arthurmint/WearablePWV/README.md

# WearablePWV
A wearable, wireless sensor for measuring pulse-wave velocity in humans
