arthurmint/WearablePWV/Electronics/Optical Board/Optical Board.step

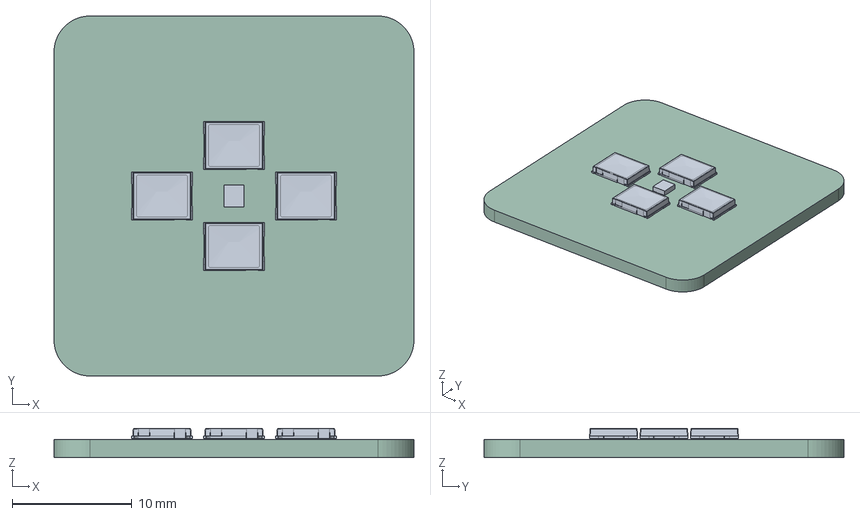
[picture p1: CAD file, 2025-12-23]
Electronics/Optical Board/Optical Board.step
30.0 x 30.0 x 2.45 mm
SFH_7016_20230526_geometry
SFH_2200_20170928_geometry x 4
Optical Board_PCB
