arthurmint/WearablePWV/Electronics/V1/V1.step

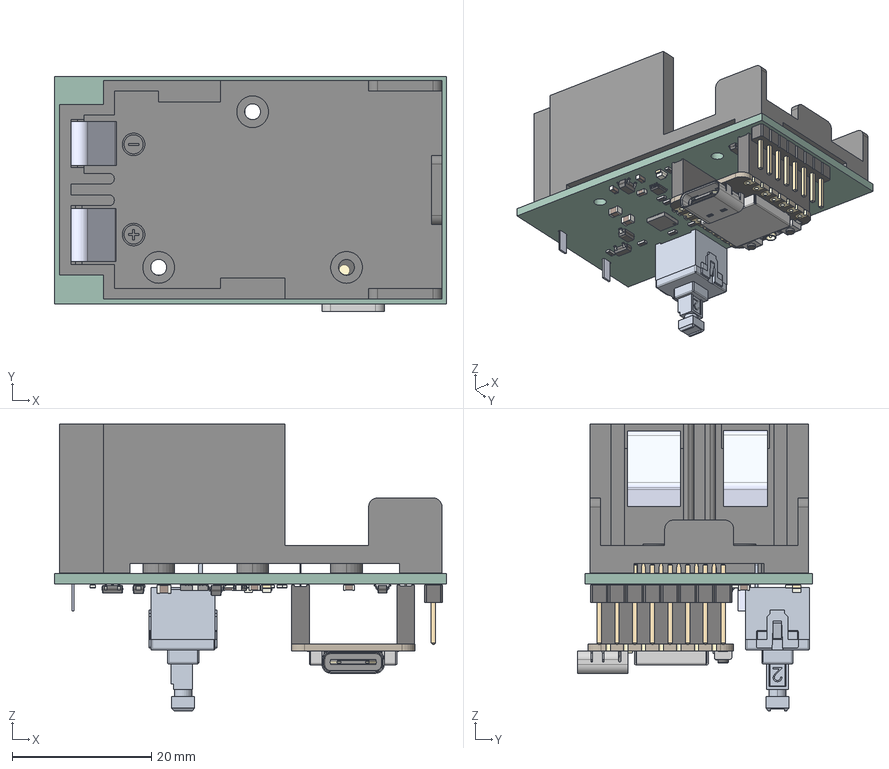
[picture p2: CAD file, 2025-12-23]
Electronics/V1/V1.step
56.3 x 33.8 x 41.2 mm
BA9VPC
C_0603_1608Metric x 10
R_0603_1608Metric x 14
LED_0805_2012Metric x 2
PinHeader_1x08_P2.54mm_Vertical
C_0805_2012Metric x 2
BOSS-EXTRUDE14_8_
BOSS-EXTRUDE7_4_
BOSS-EXTRUDE7_3_
BOSS-EXTRUDE14_4_
BOSS-EXTRUDE14_2_
BOSS-EXTRUDE14_11_
BOSS-EXTRUDE7_7_
BOSS-EXTRUDE14_9_
BOSS-EXTRUDE14_3_
BOSS-EXTRUDE14_7_
MIRROR2
BOSS-EXTRUDE14_5_
BOSS-EXTRUDE14_12_
BOSS-EXTRUDE7_8_
BOSS-EXTRUDE7_1_
BOSS-EXTRUDE14_10_
BOSS-EXTRUDE7_9_
BOSS-EXTRUDE14_6_
BOSS-EXTRUDE14_1_
BOSS-EXTRUDE7_6_
BOSS-EXTRUDE7_2_
CUT-EXTRUDE5
BOSS-EXTRUDE7_5_
U.FL Connector v1
Button (1) x 2
Shield
PinSocket_1x07_P2.54mm_Vertical v1 x 2
SOT-23-5
V1 1.18.1
ThermalPin
PinsArrayLR
PinsArrayTB
VSSOP-8_2.3x2mm_P0.5mm x 2
D_SOD-123
SOT-23 x 2
V1_PCB
