arthurmint/WearablePWV/Electronics/Optical Board/Optical Board.kicad_pcb

## KiCad design Electronics/Optical Board/Optical Board.kicad_pcb (2025-12-23)

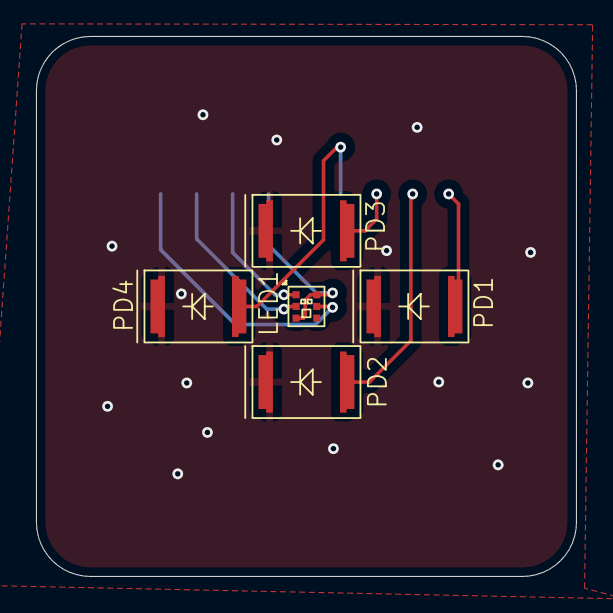
[picture p3: board Optical Board.kicad_pcb from above]

Board: 2 copper layers, 30.0 x 30.0 mm, 6 parts (1 on the bottom side), 9 nets.

Parts:
J2: OPTICAL; JST_PH_S9B-PH-SM4-TB_1x09-1MP_P2.00mm_Horizontal
LED1: SFH-7016; SFH-7016 Multi Chip LED
PD1, PD2, PD3, PD4: SFH2200; TOPLED D5140

Connections:
+3V3: J2.4, LED1.2 (A), LED1.5 (A)
/LED1: J2.3, LED1.1 (KIR)
/LED2: J2.2, LED1.3 (KGREEN)
/LED3: J2.1, LED1.4 (KRED)
/PD1: J2.9, PD1.2 (A)
/PD2: J2.8, PD2.2 (A)
/PD3: J2.7, PD3.2 (A)
/PD4: J2.6, PD4.2 (A)
/PD_K: J2.5, PD1.1 (K), PD2.1 (K), PD3.1 (K), PD4.1 (K)
