arthurmint/WearablePWV/Electronics/V1/V1.kicad_pcb

## KiCad design Electronics/V1/V1.kicad_pcb (2025-12-23)

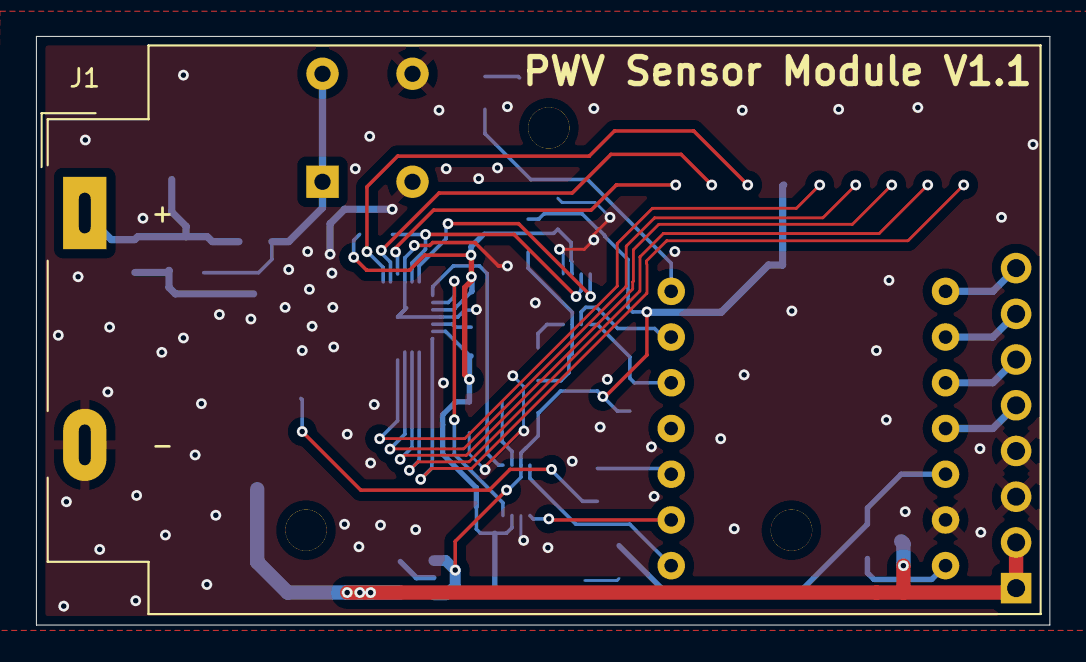
[picture p4: board V1.kicad_pcb from above]

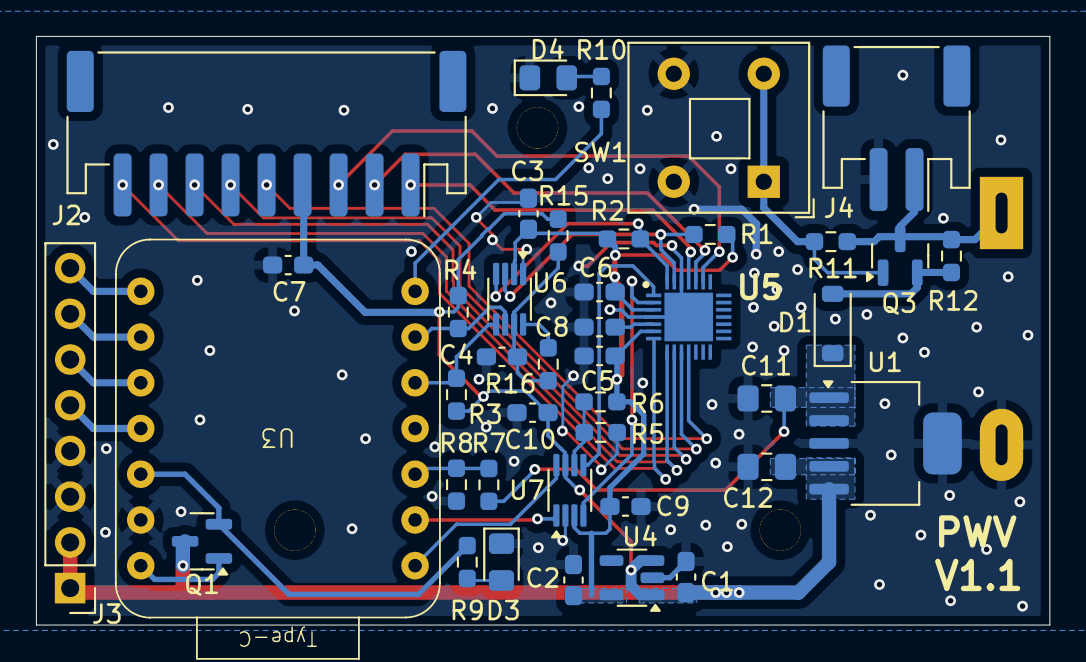
[picture p5: board V1.kicad_pcb from below]

Board: 2 copper layers, 56.3 x 32.7 mm, 42 parts (41 on the bottom side), 37 nets.

Parts:
C1, C8: 1u; C_0603_1608Metric_Pad1.08x0.95mm_HandSolder
C2: 10u; C_0603_1608Metric_Pad1.08x0.95mm_HandSolder
C3, C4, C5, C6, C9, C10: 100n; C_0603_1608Metric_Pad1.08x0.95mm_HandSolder
C7: 4u7; C_0603_1608Metric_Pad1.08x0.95mm_HandSolder
C11, C12: 10uF; C_0805_2012Metric_Pad1.18x1.45mm_HandSolder
D1: B130LAW-7-F; D_SOD-123
D3: 3V3 LED; LED_0805_2012Metric_Pad1.15x1.40mm_HandSolder
D4: CTRL LED; LED_0805_2012Metric_Pad1.15x1.40mm_HandSolder
J1: BA9VPC; BatteryHolder_MPD_BA9VPC_1xPP3
J2: OPTICAL; JST_PH_S9B-PH-SM4-TB_1x09-1MP_P2.00mm_Horizontal
J3: GPIO; PinHeader_1x08_P2.54mm_Vertical
J4: JST; JST_PH_S2B-PH-SM4-TB_1x02-1MP_P2.00mm_Horizontal
Q1, Q3: PMV41XPAR; SOT-23
R1, R2, R3, R4, R8, R11: 10k; R_0603_1608Metric_Pad0.98x0.95mm_HandSolder
R5: 200k; R_0603_1608Metric_Pad0.98x0.95mm_HandSolder
R6, R12: 0R; R_0603_1608Metric_Pad0.98x0.95mm_HandSolder
R7: 20k; R_0603_1608Metric_Pad0.98x0.95mm_HandSolder
R9, R10: 330; R_0603_1608Metric_Pad0.98x0.95mm_HandSolder
R15: 200K; R_0603_1608Metric_Pad0.98x0.95mm_HandSolder
R16: 0; R_0603_1608Metric_Pad0.98x0.95mm_HandSolder
SW1: PVA1 EE H1 3.5N V2; SW_Push_2P1T_Toggle_CK_PVA1xxH1xxxxxxV2
U1: TPS7A4533; SOT-223-6
U3: XIAO-ESP32-C3; Seeed Studio XIAO ESP32-C3
U4: TPS72218; SOT-23-5
U5: ADPD1080
U6: PCA9306DC; VSSOP-8_2.3x2mm_P0.5mm
U7: TXB0102DCU; VSSOP-8_2.3x2mm_P0.5mm

Connections:
+1V8: C2.1, C3.1, C5.1, C6.1, C9.1, R1.1, R2.1, R6.1, U4.5 (VOUT), U5.3 (DVDD), U5.6 (AVDD), U6.2 (VREF1), U7.3 (VCCA)
+3V3: C1.1, C7.1, C10.1, C12.1, J2.4, J3.1, J3.2, Q1.3 (D), R3.1, R4.1, R15.1, U1.4 (OUT), U1.5 (ADJ), U4.1 (VIN), U4.3 (EN), U7.7 (VCCB)
/AFE_0: U5.1 (GPIO0), U7.5 (A1)
/AFE_1: U5.2 (GPIO1), U7.4 (A2)
/BAT+: J1.1, J4.1, Q3.3 (D), R11.1, R12.1
/BAT_SENSE: R7.2, R8.1, U3.3 (D2)
/LED1: J2.3, U5.23 (LEDX1)
/LED2: J2.2, U5.24 (LEDX2)
/LED3: J2.1, U5.25 (LEDX3)
/PD1: J2.9, U5.7 (PD1)
/PD2: J2.8, U5.8 (PD2)
/PD3: J2.7, U5.9 (PD3)
/PD4: J2.6, U5.10 (PD4)
/PD_K: J2.5, U5.11 (PDC)
/PPG_SCL: R1.2, U5.27 (SCL), U6.3 (SCL1)
/PPG_SDA: R2.2, U5.28 (SDA), U6.4 (SDA1)
/UC_D0: U3.1 (D0), U7.8 (B1)
/UC_D1: U3.2 (D1), U7.1 (B2)
/UC_D6: R10.1, U3.7 (D6/TX)
/UC_D7: J3.8, U3.8 (D7/RX)
/UC_D8: J3.7, U3.9 (D8/SCK)
/UC_D9: J3.6, U3.10 (D9/MISO)
/UC_D10: J3.5, U3.11 (D10/MOSI)
/UC_SCL: R4.2, U3.6 (D5/SCL), U6.6 (SCL2)
/UC_SDA: R3.2, U3.5 (D4/SDA), U6.5 (SDA2)
GND: C1.2, C2.2, C3.2, C4.2, C5.2, C6.2, C7.2, C8.2, C9.2, C10.2, C11.2, C12.2, D3.1 (K), D4.1 (K), J1.2, J3.3, J3.4, J4.2, R5.2, R8.2, SW1.2, SW1.4, U1.3 (GND), U1.6 (GND), U3.13 (GND), U4.2 (GND), U5.4 (AGND), U5.26 (LGND), U5.29 (DGND), U6.1 (GND), U7.2 (GND)
unnamed: D1.2 (A), Q3.2 (S), R12.2
unnamed: D3.2 (A), R9.2
unnamed: D4.2 (A), R10.2
unnamed: Q1.2 (S), R9.1, U3.12 (3V3)
unnamed: Q3.1 (G), R11.2, SW1.1, SW1.3
unnamed: C8.1, U5.5 (VREF)
unnamed: R16.2, U6.8 (EN)
unnamed: C4.1, R15.2, R16.1, U6.7 (VREF2)
unnamed: R5.1, R6.2, U7.6 (OE)
VBAT: C11.1, D1.1 (K), R7.1, U1.1 (~SHDN), U1.2 (IN)
VUSB: Q1.1 (G), U3.14 (5V)
