arthurmint/WearablePWV/software/include/pinout.h

// refer to https://forum.arduino.cc/uploads/short-url/8KC8IkiuUXN0edlNFxIYVZgS76y.pdf for pin mappings

#define PIN_GPIO0 2
#define PIN_GPIO1 3
#define PIN_BATSENSE 4
#define PIN_SDA 6
#define PIN_SCL 7
#define PIN_LED 21
