arthurmint/WearablePWV/(commit log)

2025-11-06 Added symbol for Xiao ESP32
    [V1.kicad_pcb, V1.kicad_sch]
2025-11-09 Added more symbols
    [V1.kicad_sch]
2025-11-13 added capacitors and pull-up resistors
    [V1.kicad_sch]
2025-11-14 Added footprint for ADPD144
    [V1.kicad_sch]
2025-11-19 Added more symbols and footprints
    [V1.kicad_sch]
2025-11-25 Added footprints for SFH-7016 and TOPLED
2025-11-25 Added level shifter for gpio, 5V reg, battery monitor and changed some footprints.
    [V1.kicad_sch]
2025-11-27 Added Seeed Studio footprint
    [V1.kicad_pcb, V1.kicad_sch]
2025-12-03 Minor fixes
    [V1.kicad_pcb, V1.kicad_sch]
2025-12-05 Some unfinished PCB changes
    [V1.kicad_pcb, V1.kicad_sch]
2025-12-05 minor changes
    [V1.kicad_pcb, V1.kicad_sch]
2025-12-05 Swapped I2C shifter for PCA9306DC
    [V1.kicad_pcb, V1.kicad_sch]
2025-12-07 Changing from integrated optical sensors to separate PCB
    [Optical Board.kicad_pcb, Optical Board.kicad_sch, V1.kicad_pcb, V1.kicad_sch]
2025-12-23 Footprint changes
    [Optical Board.kicad_pcb, Optical Board.kicad_sch, Optical Board.step, V1.kicad_pcb, V1.kicad_sch, V1.step]
2026-03-24 Progress with adpd1080, just need LED and photodiode headers
2026-04-03 LED pulse working, interrupt and polling reading added but not yet working.
2026-04-04 Untested: TIA ADC Mode. WIP
2026-04-06 Made it so that you can open pwvdissertation.ino in Arduino IDE
2026-04-08 Small fixes to adpd1080.h
    [adpd1080.h]
2026-04-29 Changes to the ADPD1080 to prevent it from saturating, see logbook
    [adpd1080.h, adpd1080_test.ino]
